W-Floyd/midiMixer/README.md

# midiMixer

A project to create some simple, low cost MIDI mixers, so I can easily control instruments in my DAW.

This is also going to be a learning experience for me.
