W-Floyd/midiMixer/(list of files, cad)

Other CAD files:
v1/CAD/3D/Align Pots.SLDPRT
v1/CAD/3D/Clamp Pots.SLDPRT
