W-Floyd/midiMixer/v1/CAD/PCB/midiMixer.kicad_pcb

## KiCad design v1/CAD/PCB/midiMixer.kicad_pcb (2020-05-06)

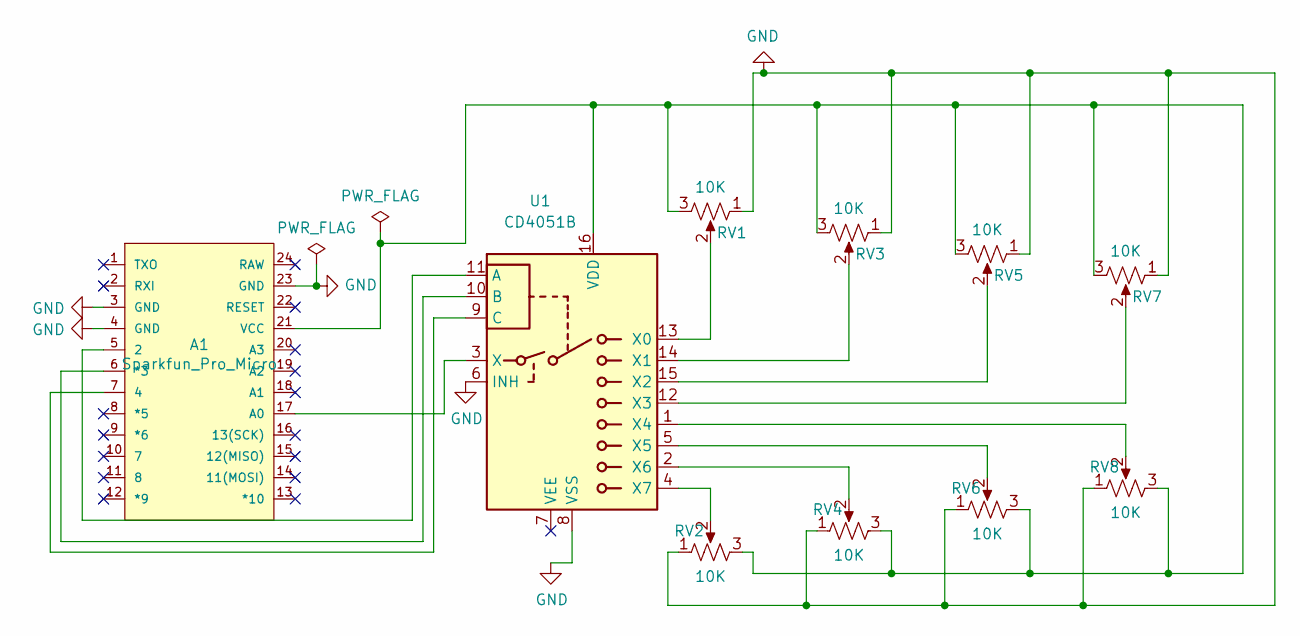
[picture p1: schematic midiMixer.sch, MIDI Mixer]

Parts:
A1: Sparkfun_Pro_Micro; SPARKFUN_PRO_MICRO
RV1, RV2, RV3, RV4, RV5, RV6, RV7, RV8: 10K; Potentiometer_Alpha_RD901F-40-00D_Single_Vertical_CircularH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
U1: CD4051B; DIP-16_W7.62mm

Connections:
GND: A1.3 (GND), A1.4 (GND), A1.23 (GND), RV1.1, RV2.1, RV3.1, RV4.1, RV5.1, RV6.1, RV7.1, RV8.1, U1.6 (INH), U1.8 (VSS)
unnamed: A1.5 (2), U1.11 (A)
unnamed: A1.6 (*3), U1.10 (B)
unnamed: A1.7 (4), U1.9 (C)
unnamed: A1.17 (A0), U1.3 (X)
unnamed: A1.21 (VCC), RV1.3, RV2.3, RV3.3, RV4.3, RV5.3, RV6.3, RV7.3, RV8.3, U1.16 (VDD)
unnamed: RV1.2, U1.13 (X0)
unnamed: RV2.2, U1.4 (X7)
unnamed: RV3.2, U1.14 (X1)
unnamed: RV4.2, U1.2 (X6)
unnamed: RV5.2, U1.15 (X2)
unnamed: RV6.2, U1.5 (X5)
unnamed: RV7.2, U1.12 (X3)
unnamed: RV8.2, U1.1 (X4)

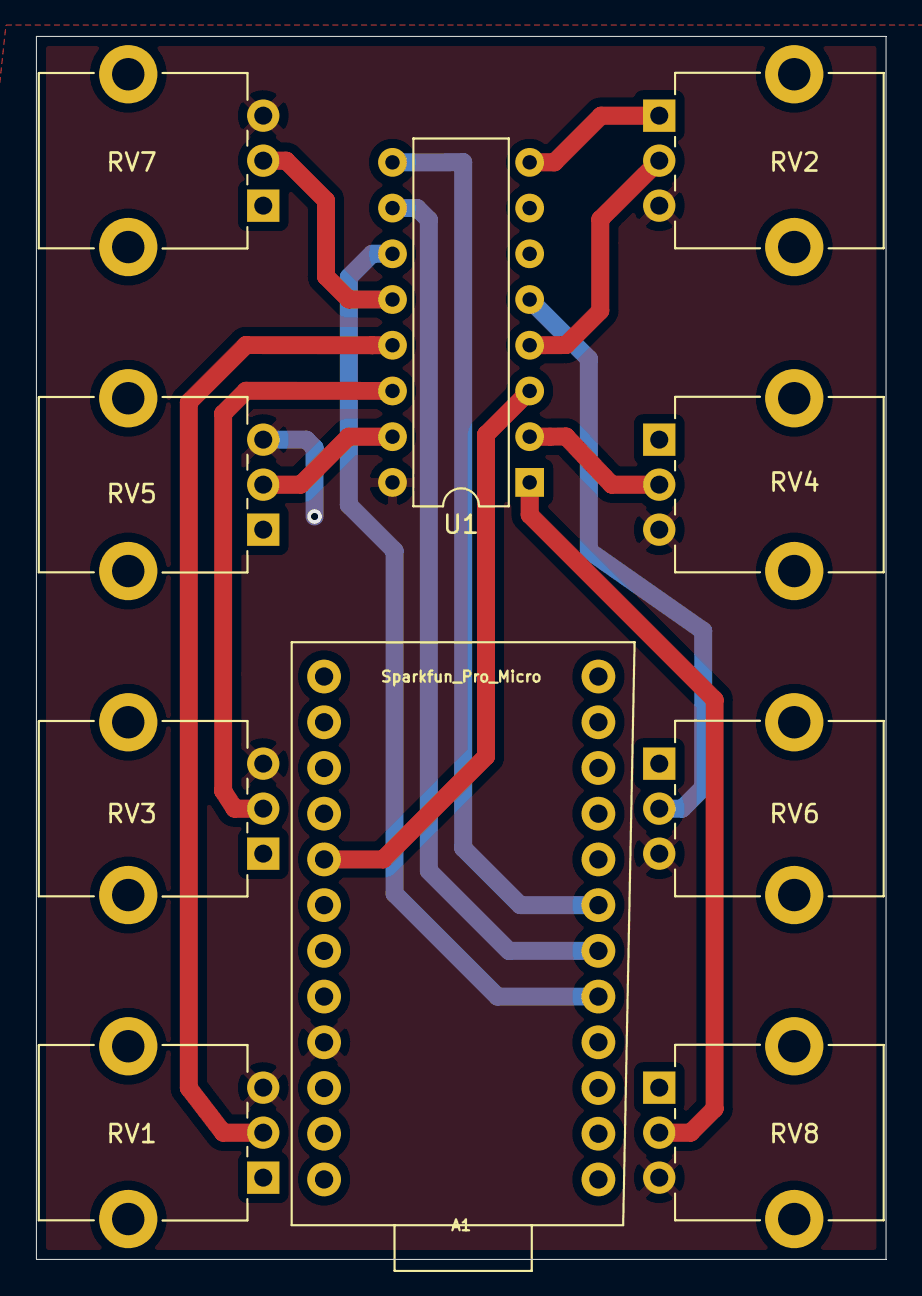
[picture p2: board midiMixer.kicad_pcb from above]

Board: 2 copper layers, 47.2 x 67.9 mm, 10 parts (0 on the bottom side), 14 nets.
