W-Floyd/midiMixer/(commit log)

2020-05-06 gitattributes: Add git lfs for binary files like CAD and Gerber ZIP.
2020-05-06 v1/CAD/3D: Add some parts I printed.
    [Align Pots.SLDPRT, Clamp Pots.SLDPRT]
2020-05-06 v1/CAD/PCB: Add KiCAD files and Gerber ZIP.
    [midiMixer.kicad_pcb, midiMixer.sch]
