W-Floyd/midiMixer/(notices)

Notices in the files:
v1/CAD/PCB/midiMixer.kicad_pcb:
©William Floyd 2020
